tynix5/balance_bot/(commit log)

2025-01-09 Added I2C, getting errors on byte transfers and timeouts on addr status bit
    [main.c]
2025-01-09 Added I2C driver. Frequent timeouts when checking ADDR status bit and BTF flag
2025-01-10 Initialize I2C clock before configuring GPIO
2025-01-12 Tested BNO055 sensor at 300kHz, working correctly
    [main.c]
2025-01-14 Added UART for debugging
2025-01-16 Made quick and dirty functions to read Euler angles and print them over serial
2025-01-20 Reading fusion data, adding PID controller WIP
2025-01-21 Added tim2 to control PWM. WIP
2025-01-22 Added PWM. WIP integrating PID controller
2025-01-27 Added motor driving software. Need to test and configure PI values
2025-01-28 Changed motor implementation. Need to adjust PI values
2025-01-29 Added derivative component to PID controller. Added automatic motor shutoff when bot tips over; Need to adjust PID values
2025-01-31 Experimenting with using quadratic input mapping instead of linear. Need to adjust PID values
2025-02-10 Changed to only PD. Modified motor pwm controller and testing values
2025-04-19 Restructured PID loop and renamed functions
2025-05-01 Cleaned up project. Moved i2c and uart libraries outside balance_bot
2025-05-11 Added positional term without encoders.
2025-05-14 Final revision before adding encoder logic
2025-05-20 Enabled pullups for encoder open-drain outputs
2025-05-21 Changed encoder PID to run at a rate of ~14Hz. Modified PID constants. Robot is balancing perfectly on its own
2025-05-21 Modified PID constants for encoder dt. Robot balancing perfectly on its own
2025-07-29 Modified IMU address for clone BNO055
2025-07-30 Added user LED for PCB
2025-08-01 Added PCB rev 1.0-1.2
    [balance_bot-B_Cu.gbr, balance_bot-B_Mask.gbr, balance_bot-B_Paste.gbr, balance_bot-B_Silkscreen.gbr, balance_bot-Edge_Cuts.gbr, balance_bot-F_Cu.gbr, balance_bot-F_Mask.gbr, balance_bot-F_Paste.gbr]
